M0WUT/WINK3Y/Parts.xlsx

Qty | Value | Parts | Farnell Number | Unit cost (GBP exc VAT) | Total (GBP inc VAT)
1 | PCB |  |  |  | 1.5
1 |  | FB1 | RS: 724-1532 | 0.05 | 0.06
7 | 100nF | C1, C2, C3, C4, C5, C7, C8 | 2810260 | 0.014 | 0.1176
1 | 10k | R5 | 2059239 | 0.016 | 0.0192
1 | 1k5 | R2 | 2072645 | 0.008 | 0.0096
1 | 1k5 | RN2 | 2333509 | 0.068 | 0.0816
1 | 33nF | C6 | 1865445 | 0.054 | 0.0648
2 | 470R | R1, R3 | 2447178 | 0.004 | 0.0096
1 | 4k7 | RN1 | 1770136 | 0.061 | 0.0732
1 | 6MHz | X1 | 1170434 | 0.284 | 0.3408
1 | CONN_DB9_MALE | CN1 | 698064 | 0.332 | 0.3984
1 | D SUB BACKSHELL | N/A | 2346835 | 0.714 | 0.8568
1 | FT2232D | IC2 | 1615843 | 5.26 | 6.312
1 | IC_AQY280S | IC4 | RS: 811-3296 | 1.42 | 1.704
1 | IC_MAX3313 | IC3 | 2511704 | 1.4 | 1.68
1 | LED_KINGBRIGHT_KPTB | LD2 | 2426236 | 0.098 | 0.1176
1 | WINKEYER | IC1 | N/A | ~10USD
368 |  |  |  | TOTAL: | 13.35 | (plus Winkeyer)
