M0WUT/WINK3Y/Schematic.pdf

# GND GND

# Winkey

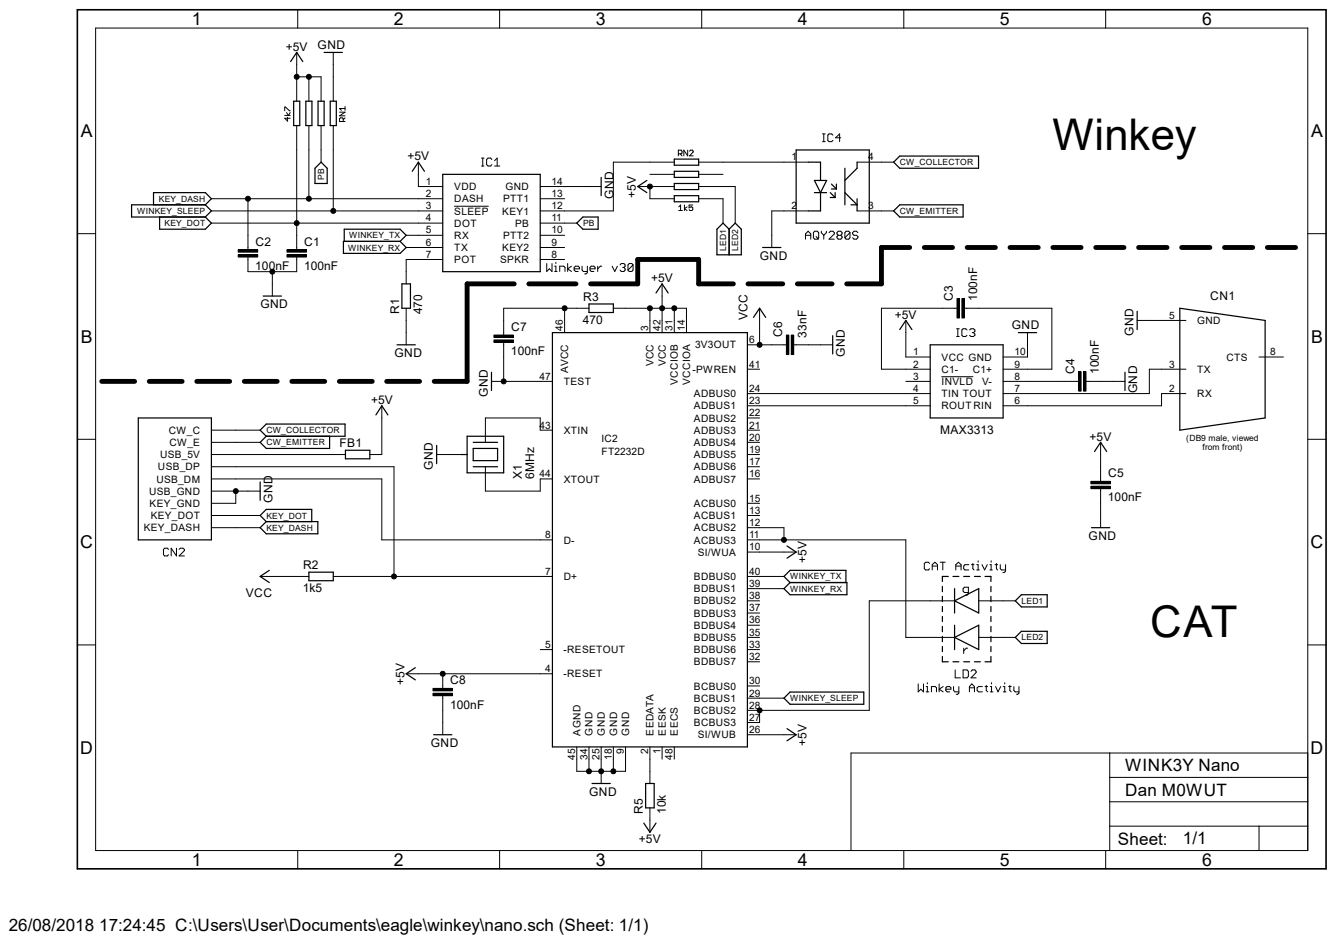
[picture p1: page 1]

SLEEP 3
DOT 4
RX 5
