M0WUT/WINK3Y/placement.pdf

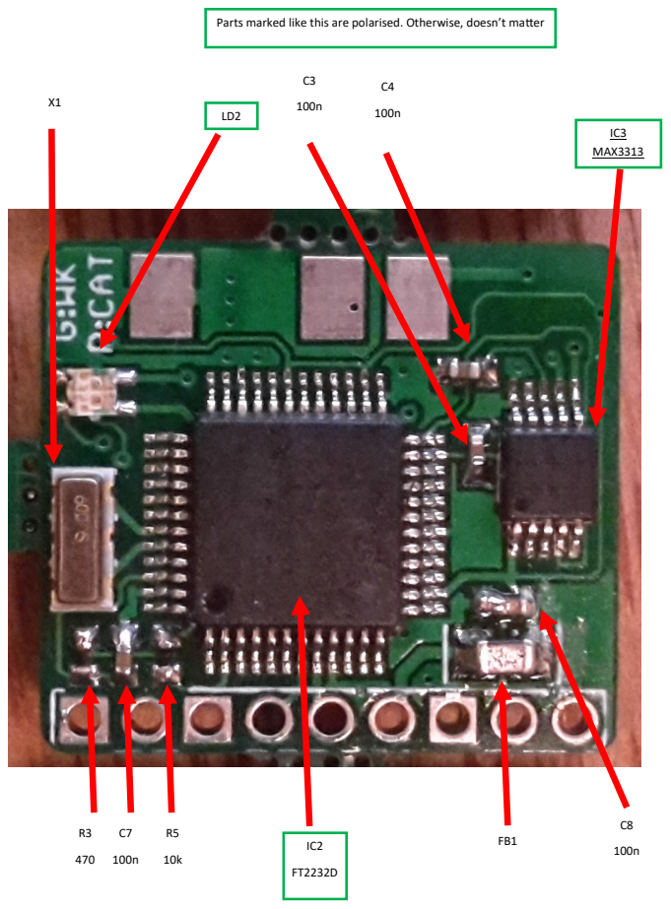
[picture p2: page 1]

Parts marked like this are polarised. Otherwise, doesn’t matter

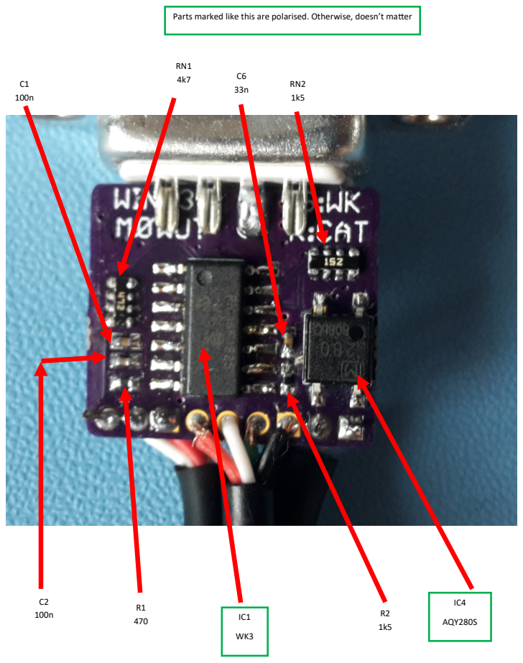
[picture p3: page 2]

Parts marked like this are polarised. Otherwise, doesn’t matter
