M0WUT/WINK3Y/nano.brd

## EAGLE design nano.brd (2018-10-30)

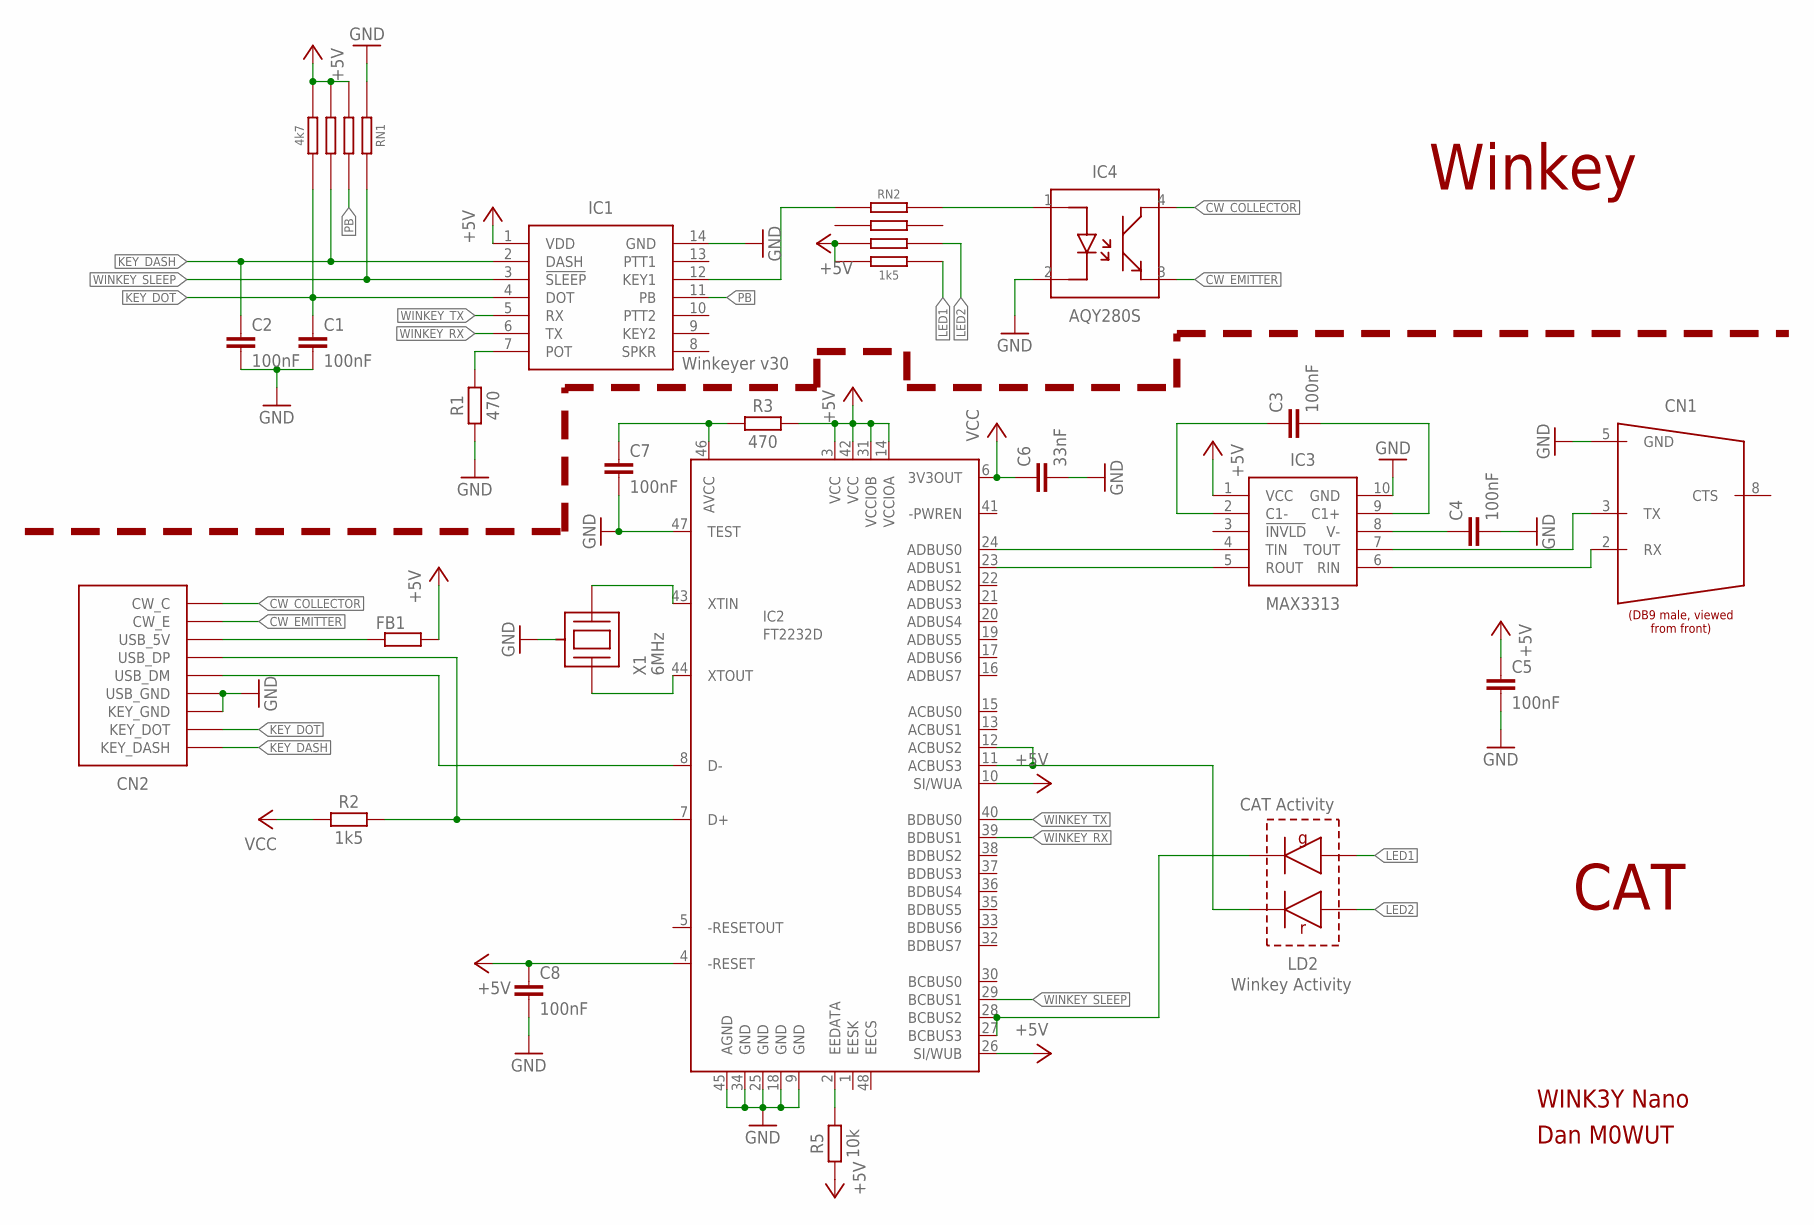
[picture p4: schematic nano.sch]

Parts:
C1, C2, C3, C4, C5, C7, C8: 100nF; C0402
C6: 33nF; C0402
CN1: CONN_DB9_MALE; CONN_DB9
CN2: CONN_WINK3Y; CONN_2MMX9
FB1: R-EU_R0805; R0805
IC1: WINKEYER; SO14
IC2: FT2232D; QFP48-7X7
IC3: IC_MAX3313; IC_UMAX10
IC4: IC_AQY280S
LD2: LED_KINGBRIGHT_KPTB
R1, R3: 470; R0402
R2: 1k5; R0402
R5: 10k; R0402
RN1: 4k7; R_BOURNS_CAY16-J4
RN2: 1k5; R_BOURNS_CAY16-J4
X1: 6MHz; XTAL_MURATA_3-PIN-RES

Connections:
+5V: C5.1, C8.1, FB1.2, IC1.1 (VDD), IC2.3 (VCC), IC2.4 (-RESET), IC2.10 (SI/WUA), IC2.14 (VCCIOA), IC2.26 (SI/WUB), IC2.31 (VCCIOB), IC2.42 (VCC), IC3.1 (VCC), R3.2, R5.1, RN1.2, RN1.3, RN1.4, RN2.3, RN2.4
CAT_RX: IC2.23 (ADBUS1), IC3.5 (ROUT)
CAT_TX: IC2.24 (ADBUS0), IC3.4 (TIN)
CW_COLLECTOR: CN2.CW_COLLECTOR (CW_C), IC4.4 (COLLECTOR)
CW_EMITTER: CN2.CW_EMITTER (CW_E), IC4.3 (EMITTER)
GND: C1.2, C2.2, C4.2, C5.2, C6.2, C7.2, C8.2, CN1.5 (GND), CN2.KEY_GND, CN2.USB_GND, IC1.14 (GND), IC2.9 (GND), IC2.18 (GND), IC2.25 (GND), IC2.34 (GND), IC2.45 (AGND), IC2.47 (TEST), IC3.10 (GND), IC4.2 (CATHODE), R1.1, RN1.1, X1.GND (CAN)
KEY_DASH: C2.1, CN2.KEY_DASH, IC1.2 (DASH), RN1.3A
KEY_DOT: C1.1, CN2.KEY_DOT, IC1.4 (DOT), RN1.4A
LED1: LD2.3 (G_ANODE), RN2.4A
LED2: LD2.1 (R_ANODE), RN2.3A
unnamed: C7.1, IC2.46 (AVCC), R3.1
unnamed: CN2.USB_5V, FB1.1
unnamed: IC2.43 (XTIN), X1.2 (XTAL2)
unnamed: CN1.3 (TX), IC3.7 (TOUT)
unnamed: CN1.2 (RX), IC3.6 (RIN)
unnamed: C3.1, IC3.2 (C1-)
unnamed: C3.2, IC3.9 (C1+)
unnamed: C4.1, IC3.8 (V-)
unnamed: IC2.44 (XTOUT), X1.1 (XTAL1)
unnamed: CN2.USB_DM, IC2.8 (D-)
unnamed: IC1.12 (KEY1), RN2.1
unnamed: IC4.1 (ANODE), RN2.1A
unnamed: IC1.7 (POT), R1.2
unnamed: IC2.11 (ACBUS3), IC2.12 (ACBUS2), LD2.2 (R_CATHODE)
unnamed: IC2.2 (EEDATA), R5.2
unnamed: CN2.USB_DP, IC2.7 (D+), R2.2
PB: IC1.11 (PB), RN1.2A
VCC: C6.1, IC2.6 (3V3OUT), R2.1
WINKEY_ACT: IC2.27 (BCBUS3), IC2.28 (BCBUS2), LD2.4 (G_CATHODE)
WINKEY_RX: IC1.6 (TX), IC2.39 (BDBUS1)
WINKEY_SLEEP: IC1.3 (!SLEEP), IC2.29 (BCBUS1), RN1.1A
WINKEY_TX: IC1.5 (RX), IC2.40 (BDBUS0)

Notes on the sheet:
Winkey
CAT
WINK3Y Nano
Dan M0WUT
Winkeyer v30
CAT Activity
Winkey Activity

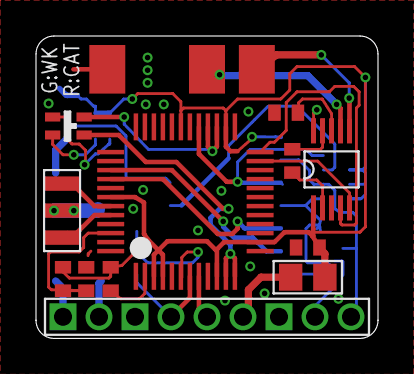
[picture p5: board nano.brd from above]

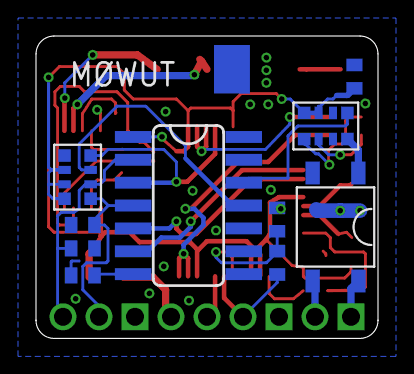
[picture p6: board nano.brd from below]

Board: 2 copper layers, 19.0 x 16.8 mm, 23 parts (10 on the bottom side), 32 nets.
